timembedded/msx-hardware/fs-a1gt/turbo-r-1mb/doc/mapper-pcb-front.jpg

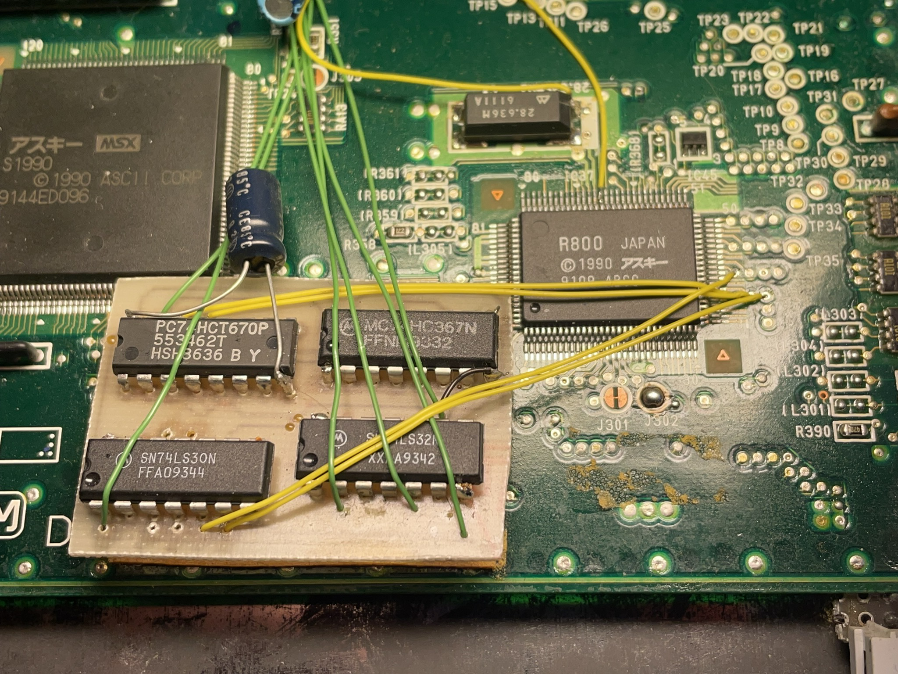
fs-a1gt/turbo-r-1mb/doc/mapper-pcb-front.jpg
