timembedded/msx-hardware/fs-a1gt/turbo-r-1mb/doc/mapper-pcb-back.jpg

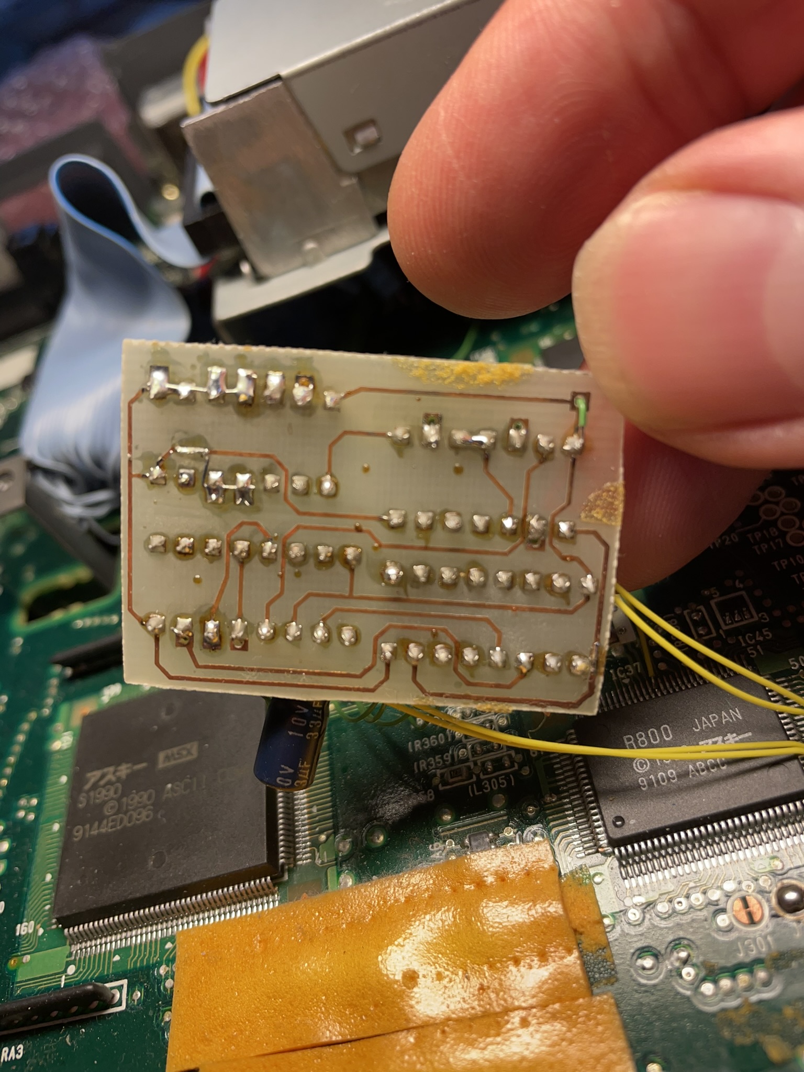
fs-a1gt/turbo-r-1mb/doc/mapper-pcb-back.jpg
