timembedded/msx-hardware/README.md

# msx-hardware
MSX hardware related things
