timembedded/msx-hardware/fs-a1gt/doc/panasonicturborreplacebelt.pdf

# TurboR: replace the belt Floppy disk drive

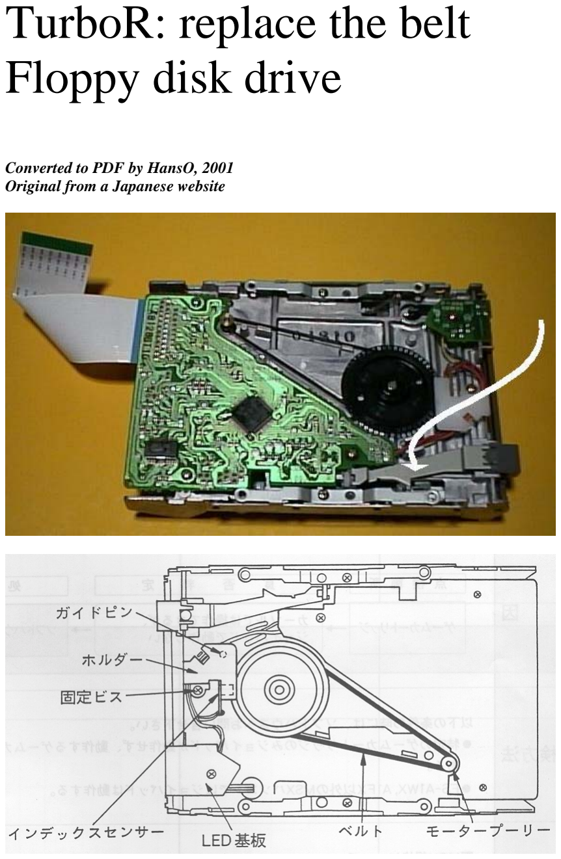
[picture p11: page 1]

Converted to PDF by HansO, 2001 Original from a Japanese website

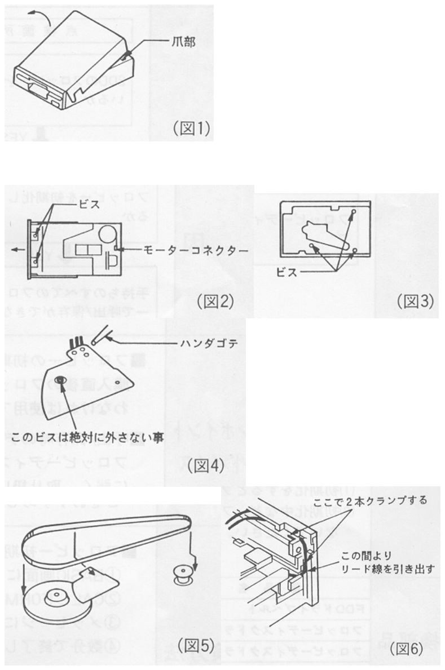
[picture p12: page 2]
