timembedded/msx-hardware/fs-a1gt/turbo-r-1mb/doc/r800-connections.jpg

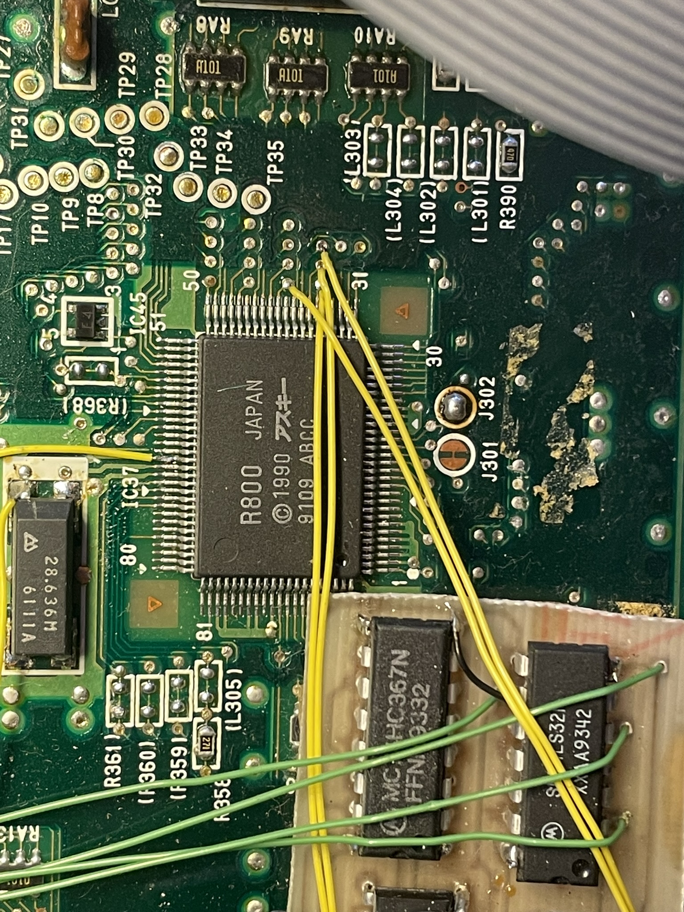
fs-a1gt/turbo-r-1mb/doc/r800-connections.jpg
