timembedded/msx-hardware/fs-a1wx/Toshiba-T9769A-Pinout.png

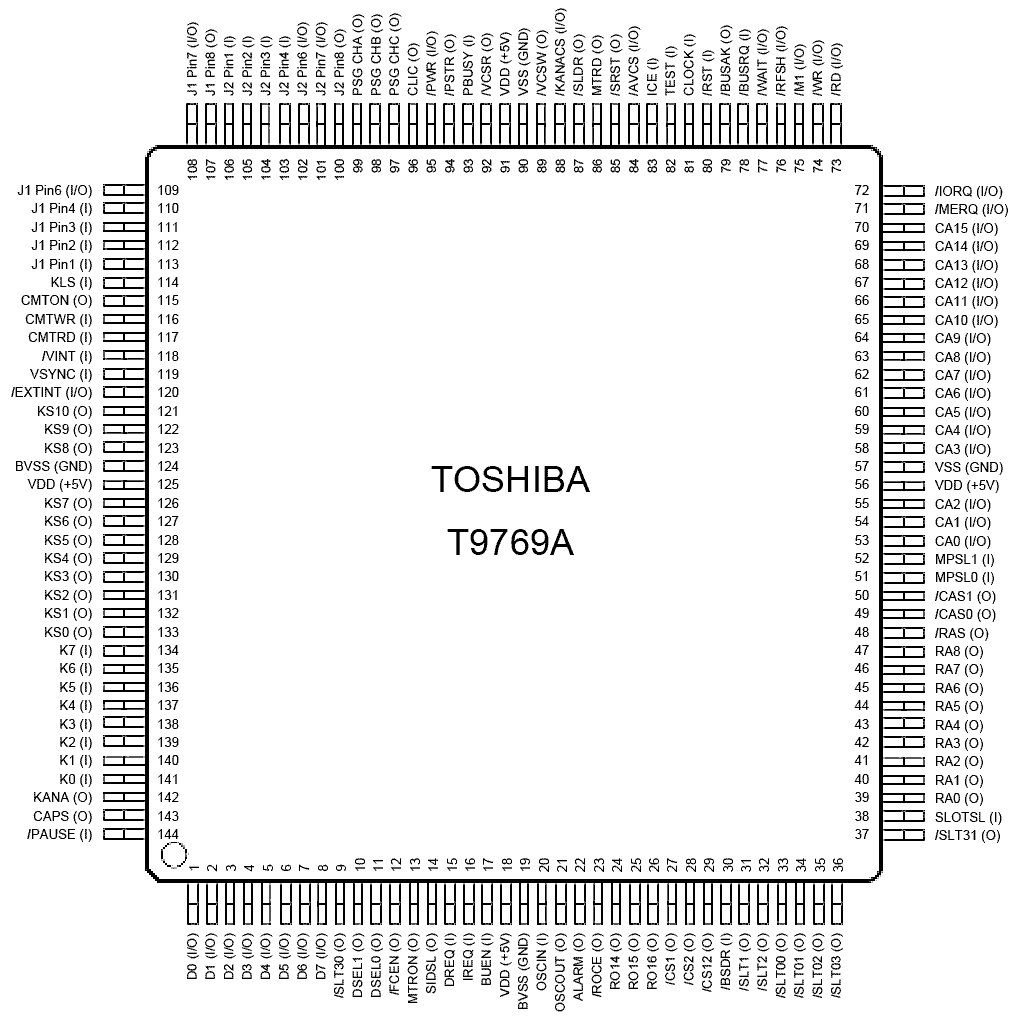
fs-a1wx/Toshiba-T9769A-Pinout.png
