timembedded/msx-hardware/fs-a1gt/turbo-r-1mb/3dmodels/220-1-08-003 3D.step

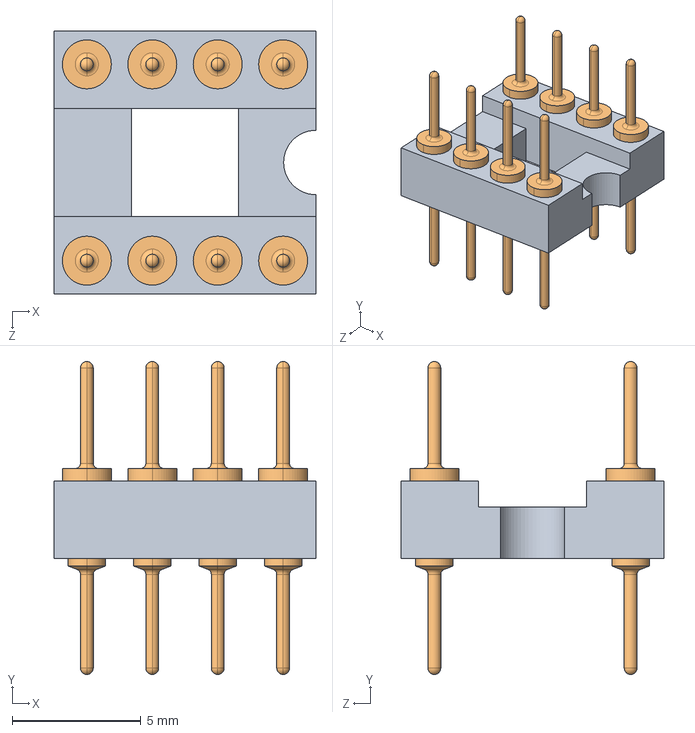
[picture p15: CAD file, 2024-09-03]
fs-a1gt/turbo-r-1mb/3dmodels/220-1-08-003 3D.step
10.2 x 12.2 x 10.2 mm
801-2227P-08-03
802-2227P-GPIN x 8
