timembedded/msx-hardware/fs-a1gt/turbo-r-1mb/turbo-r-1mb.kicad_pcb

## KiCad design fs-a1gt/turbo-r-1mb/turbo-r-1mb.kicad_pcb (2024-09-03)

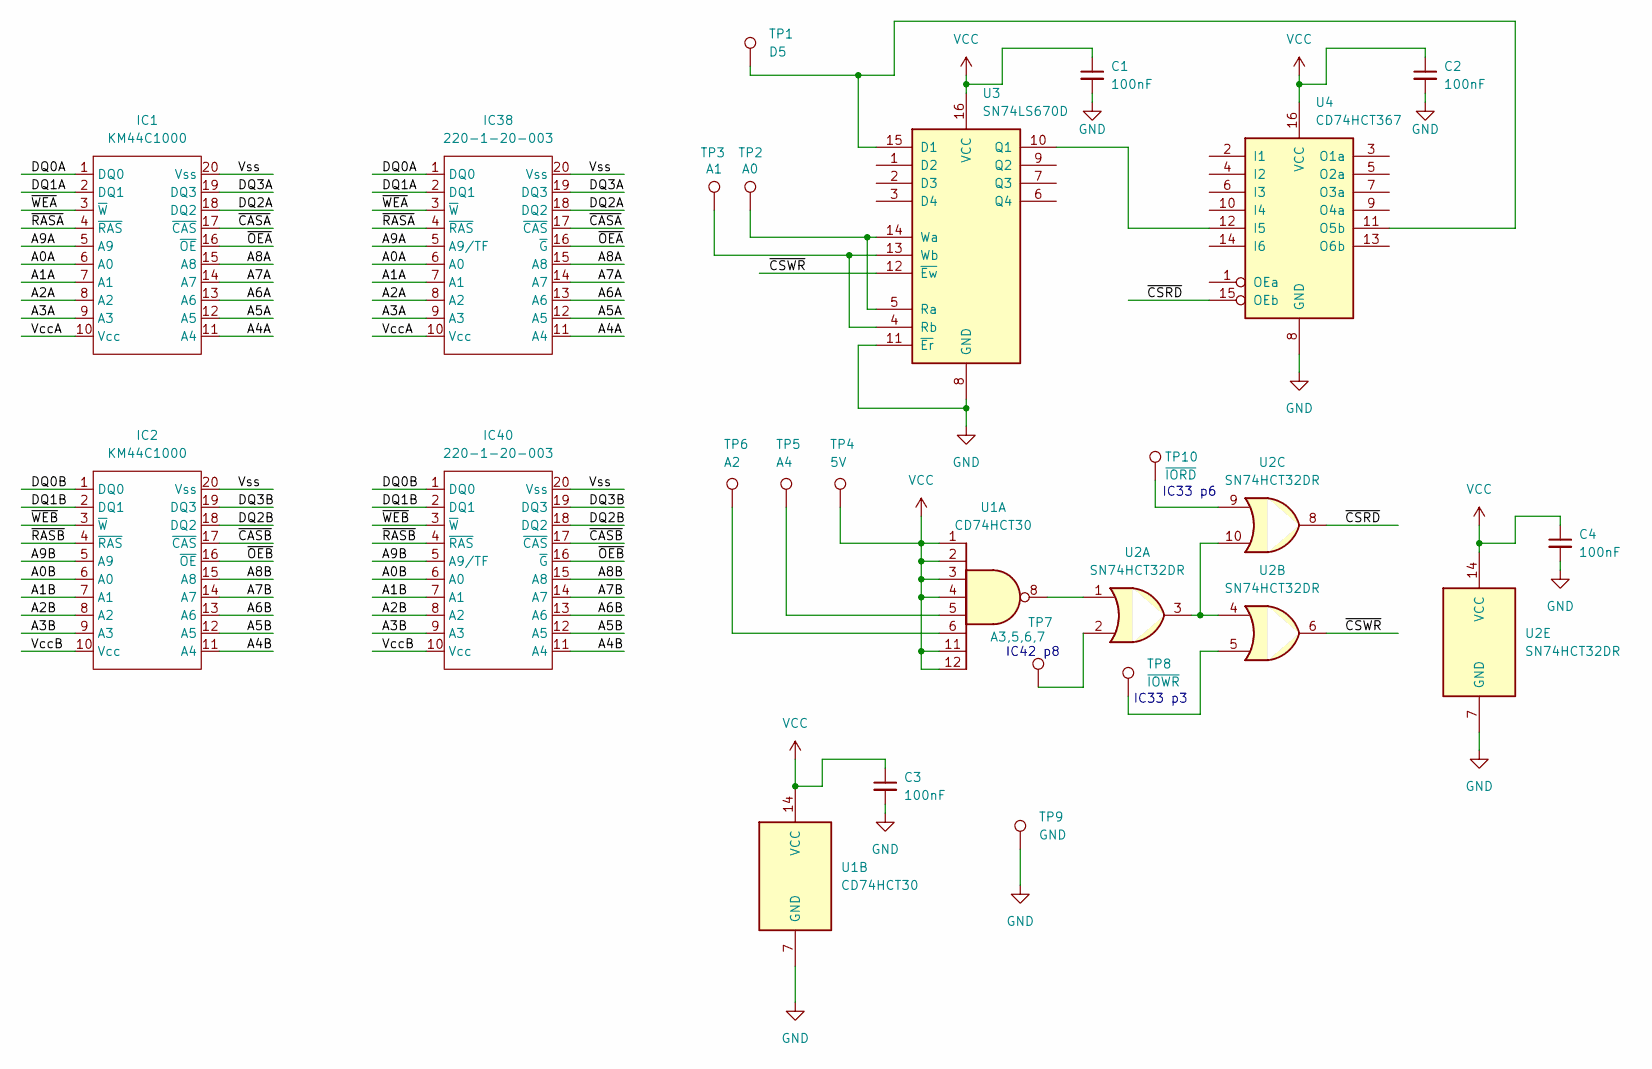
[picture p16: schematic turbo-r-1mb.kicad_sch]

Parts:
C1, C2, C3, C4: 100nF; C_0603_1608Metric; DigiKey 311-1088-1-ND
IC1, IC2: KM44C1000; SOJ-20-26_300mil; DigiKey 1175-1523-5-ND
IC38, IC40: 220-1-20-003; DIP-20_W7.62mm_B2B; DigiKey 1175-1523-5-ND
TP1: D5; TestPoint_Pad_D1.5mm
TP2: A0; TestPoint_Pad_D1.5mm
TP3: A1; TestPoint_Pad_D1.5mm
TP4: 5V; TestPoint_Pad_D1.5mm
TP5: A4; TestPoint_Pad_D1.5mm
TP6: A2; TestPoint_Pad_D1.5mm
TP7: A3,5,6,7; TestPoint_Pad_D1.5mm
TP8: ~{IOWR}; TestPoint_Pad_D1.5mm
TP9: GND; TestPoint_Pad_D1.5mm
TP10: ~{IORD}; TestPoint_Pad_D1.5mm
U1: CD74HCT30; SOIC-14_3.9x8.7mm_P1.27mm; DigiKey 296-CD74HCT30M96CT-ND
U2: SN74HCT32DR; SOIC-14_3.9x8.7mm_P1.27mm; DigiKey 296-14868-1-ND
U3: SN74LS670D; SOIC-16_3.9x9.9mm_P1.27mm; DigiKey SN74LS670D-ND
U4: CD74HCT367; SOIC-16_3.9x9.9mm_P1.27mm; DigiKey 296-31612-1-ND

Connections:
/A0A: IC1.6 (A0), IC38.6 (A0)
/A0B: IC2.6 (A0), IC40.6 (A0)
/A1A: IC1.7 (A1), IC38.7 (A1)
/A1B: IC2.7 (A1), IC40.7 (A1)
/A2A: IC1.8 (A2), IC38.8 (A2)
/A2B: IC2.8 (A2), IC40.8 (A2)
/A3A: IC1.9 (A3), IC38.9 (A3)
/A3B: IC2.9 (A3), IC40.9 (A3)
/A4A: IC1.11 (A4), IC38.11 (A4)
/A4B: IC2.11 (A4), IC40.11 (A4)
/A5A: IC1.12 (A5), IC38.12 (A5)
/A5B: IC2.12 (A5), IC40.12 (A5)
/A6A: IC1.13 (A6), IC38.13 (A6)
/A6B: IC2.13 (A6), IC40.13 (A6)
/A7A: IC1.14 (A7), IC38.14 (A7)
/A7B: IC2.14 (A7), IC40.14 (A7)
/A8A: IC1.15 (A8), IC38.15 (A8)
/A8B: IC2.15 (A8), IC40.15 (A8)
/A9A: IC1.5 (A9), IC38.5 (A9/TF)
/A9B: IC2.5 (A9), IC40.5 (A9/TF)
/DQ0A: IC1.1 (DQ0), IC38.1 (DQ0)
/DQ0B: IC2.1 (DQ0), IC40.1 (DQ0)
/DQ1A: IC1.2 (DQ1), IC38.2 (DQ1)
/DQ1B: IC2.2 (DQ1), IC40.2 (DQ1)
/DQ2A: IC1.18 (DQ2), IC38.18 (DQ2)
/DQ2B: IC2.18 (DQ2), IC40.18 (DQ2)
/DQ3A: IC1.19 (DQ3), IC38.19 (DQ3)
/DQ3B: IC2.19 (DQ3), IC40.19 (DQ3)
/VccA: IC1.10 (Vcc), IC38.10 (Vcc)
/VccB: IC2.10 (Vcc), IC40.10 (Vcc)
/Vss: IC1.20 (Vss), IC2.20 (Vss), IC38.20 (Vss), IC40.20 (Vss)
/~CASA: IC1.17 (~CAS), IC38.17 (~CAS)
/~CASB: IC2.17 (~CAS), IC40.17 (~CAS)
/~CSRD: U2.8, U4.15 (OEb)
/~CSWR: U2.6, U3.12 (~Ew)
/~OEA: IC1.16 (~OE), IC38.16 (~G)
/~OEB: IC2.16 (~OE), IC40.16 (~G)
/~RASA: IC1.4 (~RAS), IC38.4 (~RAS)
/~RASB: IC2.4 (~RAS), IC40.4 (~RAS)
/~WEA: IC1.3 (~W), IC38.3 (~W)
/~WEB: IC2.3 (~W), IC40.3 (~W)
GND: C1.2, C2.2, C3.2, C4.2, TP9.1, U1.7 (GND), U2.7 (GND), U3.8 (GND), U3.11 (~Er), U4.8 (GND)
unnamed: TP5.1, U1.5
unnamed: TP6.1, U1.6
unnamed: TP7.1, U2.2
unnamed: TP8.1, U2.5
unnamed: TP10.1, U2.9
unnamed: U1.8, U2.1
unnamed: U2.3, U2.4, U2.10
unnamed: TP1.1, U3.15 (D1), U4.11 (O5b)
unnamed: U3.10 (Q1), U4.12 (I5)
unnamed: TP2.1, U3.5 (Ra), U3.14 (Wa)
unnamed: TP3.1, U3.4 (Rb), U3.13 (Wb)
VCC: C1.1, C2.1, C3.1, C4.1, TP4.1, U1.1, U1.2, U1.3, U1.4, U1.11, U1.12, U1.14 (VCC), U2.14 (VCC), U3.16 (VCC), U4.16 (VCC)

Notes on the sheet:
IC33 p3
IC42 p8
IC33 p6

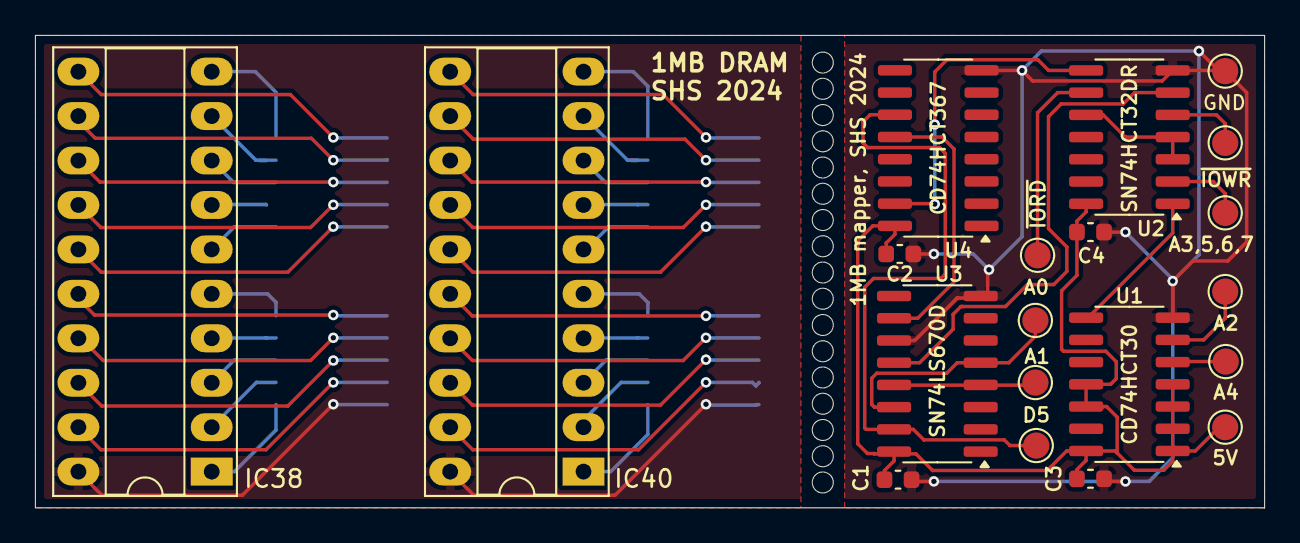
[picture p17: board turbo-r-1mb.kicad_pcb from above]

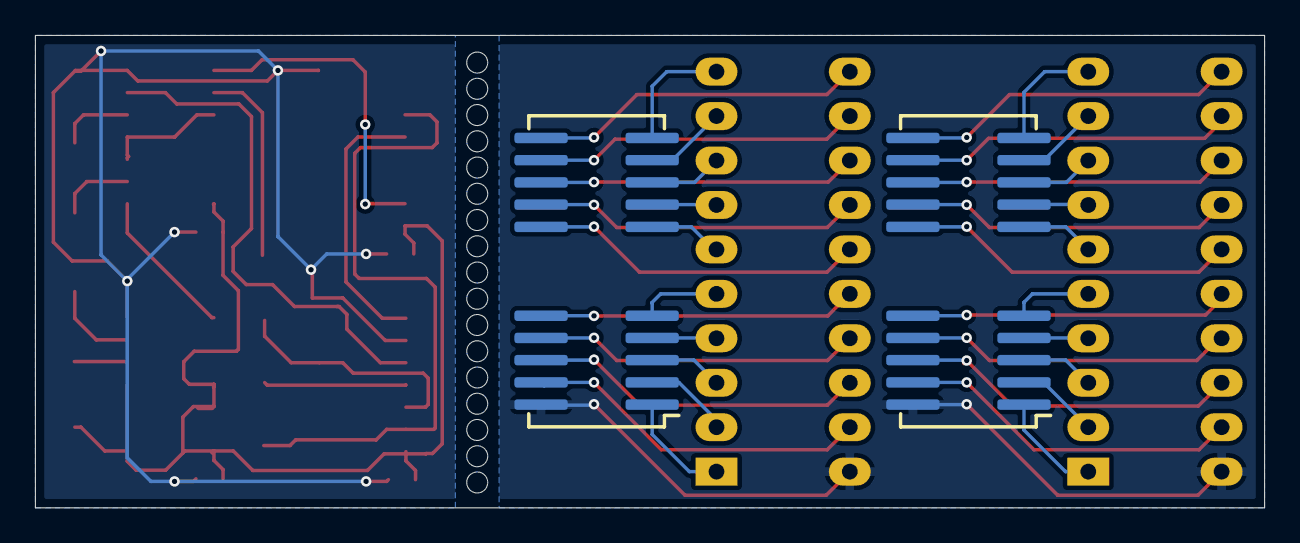
[picture p18: board turbo-r-1mb.kicad_pcb from below]

Board: 2 copper layers, 70.2 x 27.0 mm, 22 parts (2 on the bottom side), 54 nets.
