timembedded/msx-hardware/(commit log)

2024-09-02 Added pcb design for 1MB memory extension for FS-A1GT
    [turbo-r-1mb.kicad_pcb, turbo-r-1mb.kicad_sch]
2024-09-03 PCB ready for ordering
    [220-1-08-003 3D.step, turbo-r-1mb.kicad_pcb, turbo-r-1mb.kicad_sch]
